zombiell/CQ-prism-lengjing/media/指标8_尺寸规范_长度.jpg

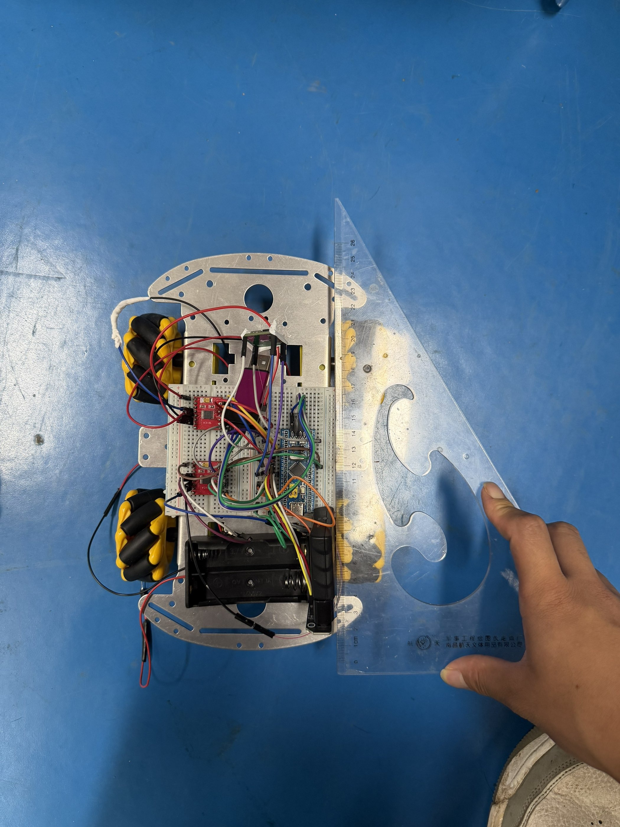
media/指标8_尺寸规范_长度.jpg
