zombiell/CQ-prism-lengjing/README.md

# CRTC2026 参赛机器人 —— 四轮麦克纳姆轮全向移动平台

> 重庆大学机器人训练大赛（CRTC2026）参赛作品
> 队伍：**CQ prism 棱镜战队**　队长：**李汶骏**

## 项目简介

本项目是一台基于 **STM32F103C8T6** 微控制器的四轮**麦克纳姆轮**全向移动机器人，通过 **PS2 无线手柄**遥控，能够实现**前进、后退、左移、右移、斜向移动、原地自转**等全向运动。

机器人的开发重点在于**底层驱动的从零实现**：PS2 手柄的通信协议由软件模拟时序实现，电机 PWM 与正反转切换由定时器直接控制，麦克纳姆轮的逆运动学解算与死区补偿算法均在固件中自行推导与实现。

## 队伍成员与分工

| 姓名 | 角色 | 职责 |
| --- | --- | --- |
| 李汶骏 | 队长 / 电控·硬件 / **操作手** | 统筹规划、对外沟通；嵌入式程序编写、电路设计、控制单元调试；比赛现场操作机器人 |
| 王佳杰 | 机械 | 机械结构设计、组装与维护 |
| 敬杨 | 机械 | 机械结构设计、组装与维护 |
| 付国强 | 机械 | 机械结构设计、组装与维护 |

> 比赛现场由李汶骏担任操作手（规则允许每队不超过 2 人进场，本队安排 1 人操作）。

## 技术规格

| 项目 | 参数 |
| --- | --- |
| 主控芯片 | STM32F103C8T6（ARM Cortex-M3，72MHz，64KB Flash，20KB RAM） |
| 电机驱动 | DRV8833 双 H 桥驱动模块 **× 2**（每模块驱动 2 个电机） |
| 电机 | TT 减速马达 × 4（单轴 1:48） |
| 轮系 | 60mm 麦克纳姆轮 × 4（X 形布局） |
| 遥控方式 | PS2 无线手柄 + 接收器（2.4GHz） |
| PWM 频率 | 20kHz（72MHz ÷ 3600） |
| 遥控信号刷新率 | 100Hz（每 10ms 一次） |
| 供电 | **2S 18650 锂电池组**（额定 **7.4V**，满电 8.4V，实测空载 8.0V），仅 1 个供电模块 |
| 调试接口 | USART1 @ 115200bps |

## 已完成的功能指标

| 编号 | 指标名称 | 实现方式 |
| --- | --- | --- |
| 1 | 外形展示 | ✅ 具备**能量单元**的完整机体（四轮麦轮底盘 + 电源 + 主控 + 能量单元安装位）；绕车一周展示视频已录制 |
| 2 | 电机运动（单一） | ✅ 已实现 `chassis_wheel_test()` 可单独驱动任意一个电机；视频已录制 |
| 3 | 电机运动（全部） | ✅ **8 路 PWM**（4 个电机 × 2 路）同时输出；视频已录制 |
| 6 | 底盘运动（单一） | ✅ PS2 手柄控制单方向平移；视频已录制（手柄与车体同框） |
| 7 | 底盘运动（全部） | ✅ PS2 手柄控制全向运动；视频已录制（手柄与车体同框） |
| 8 | 尺寸规范 | ✅ 实测 **187×169×130 mm**、**1.08 kg**（限值 290×195×210mm、2.0kg） |
| 11 | 结构稳定性 | ✅ 180mm 底面朝下自由落体，**无零件掉出**；视频已录制 |
| 12 | 规划/现有采购单 | ✅ 选型对比与成本核算 ¥178.75，见 [docs/02](./docs/02-需求分析与选型采购.md) |

**已完成的 8 项基础功能指标：1、2、3、6、7、8、11、12，演示视频全部录制完成。**

**未完成的 4 项指标（舵机运动 4、5；方块携带 9、10）**：原因与后续计划见
[docs/11 舵机运动](./docs/11-舵机运动.md) 与 [docs/12 方块携带](./docs/12-方块携带.md)。

## 目录结构

```
.
├── README.md                     本文件
├── docs/                         中期考核技术文档（Markdown）
│   ├── README.md                 文档导航页
│   ├── 01-项目概述与技术路线.md
│   ├── 02-需求分析与选型采购.md
│   ├── 03-电源管理与电气规范.md
│   ├── 04-电机驱动与PWM调速.md
│   ├── 05-麦克纳姆轮运动学解算.md
│   ├── 06-PS2手柄通信与遥控.md
│   ├── 07-底盘结构与外形.md
│   ├── 08-尺寸测量与结构强度.md
│   ├── 09-调试过程与问题排查.md
│   ├── 10-开源项目使用说明.md
│   ├── 11-舵机运动.md            未完成指标说明
│   └── 12-方块携带.md            未完成指标说明
├── firmware/                     固件完整源码
│   ├── Core/                     Inc / Src
│   ├── Drivers/                  STM32F1 HAL 库 + CMSIS
│   ├── cmake/                    交叉编译工具链配置
│   ├── CMakeLists.txt
│   ├── CMakePresets.json
│   ├── startup_stm32f103xb.s     启动文件
│   ├── STM32F103xx_FLASH.ld      链接脚本
│   └── romote_movtion.ioc        CubeMX 工程文件
└── media/                        演示图片
```

## 固件结构

| 文件 | 层次 | 职责 |
| --- | --- | --- |
| `Core/Src/ps2.c` | 驱动层 | 软件模拟 SPI 时序，读取 PS2 手柄 9 字节数据帧并校验 |
| `Core/Src/motor.c` | 驱动层 | 浮点占空比 → 定时器比较值；含软启动斜坡与**马达死区补偿** |
| `Core/Src/chassis.c` | 算法层 | 麦轮逆运动学解算、归一化、四轮降额 |
| `Core/Src/main.c` | 应用层 | 时间片调度、按键解析、急停安全逻辑、调试打印 |

## 快速开始

1. 用 STM32CubeIDE 或 CMake + arm-none-eabi-gcc 打开 **`firmware/`** 目录（源码根目录含 `CMakeLists.txt`）
2. 编译生成 `.hex` / `.bin`
3. 用 ST-Link 烧录到 STM32F103C8T6
4. 按下表连接 PS2 接收器：

   | 接收器引脚 | STM32 引脚 |
   | --- | --- |
   | GND | GND |
   | VCC | 3.3V 或 5V |
   | DATA | PA4 |
   | CMD | PA5 |
   | CS | PA6 |
   | CLK | PA7 |

5. 上电后**先按一次 START 键**解除急停锁存，即可用手柄遥控

## 操作映射

| 手柄按键 | 机器人动作 |
| --- | --- |
| ↑ / ↓ | 前进 / 后退 |
| ← / → | 左移 / 右移 |
| ↑ + ← / ↑ + → 等 | 斜向 45° 移动（四组） |
| ○ / □ | 原地顺时针 / 逆时针自转 |
| 方向键 + ○/□ | 边走边转 |
| **START** | 解除急停锁存 |
| **SELECT** | 紧急停车（锁存，需 START 解除） |

> 本手柄摇杆无模拟量输出（官方手册明确说明），因此**必须使用十字方向键**控制，推摇杆不会产生平移。

## 文档

全部技术文档在 **[`docs/`](./docs/)** 目录，共 **10 篇**，入口见 [docs/README.md](./docs/README.md)（文档导航页）。

| 文档 | 对应指标 |
| --- | --- |
| [01 项目概述与技术路线](./docs/01-项目概述与技术路线.md) | — |
| [02 需求分析与选型采购](./docs/02-需求分析与选型采购.md) | 12 |
| [03 电源管理与电气规范](./docs/03-电源管理与电气规范.md) | — |
| [04 电机驱动与PWM调速](./docs/04-电机驱动与PWM调速.md) | 2、3 |
| [05 麦克纳姆轮运动学解算](./docs/05-麦克纳姆轮运动学解算.md) | — |
| [06 PS2手柄通信与遥控](./docs/06-PS2手柄通信与遥控.md) | 6、7 |
| [07 底盘结构与外形](./docs/07-底盘结构与外形.md) | 1 |
| [08 尺寸测量与结构强度](./docs/08-尺寸测量与结构强度.md) | 8、11 |
| [09 调试过程与问题排查](./docs/09-调试过程与问题排查.md) | — |
| [10 开源项目使用说明](./docs/10-开源项目使用说明.md) | — |

## 开源说明

本项目在开发过程中使用了 STM32 HAL 库、CMSIS 等开源组件，并参考了塔克创新（XTARK）的 PS2 手柄驱动结构（代码已重写）。
完整的开源组件清单、许可证、以及我们对参考实现的修改说明，见 **[10 开源项目使用说明](./docs/10-开源项目使用说明.md)**。
