zombiell/CQ-prism-lengjing/docs/10-开源项目使用说明.md

# 10 开源项目使用说明

> 依据竞赛手册第 3 章要求：
> 「**参赛队伍应自行制作参赛机器人**……将**开源项目用于机器人的制作及代码编写是允许的，但必须在中期考核阶段给出完整说明**，并遵守所使用开源项目的开源协议。」

本篇完整说明本项目使用的所有开源组件、许可证、以及我们对开源代码的修改与二次开发内容。

---

## 开源组件清单

| # | 组件 | 版本 | 来源 | 许可证 | 在本项目中的用途 |
| --- | --- | --- | --- | --- | --- |
| 1 | **STM32F1xx HAL Driver** | CubeMX 生成 | STMicroelectronics | **BSD-3-Clause** | 外设驱动（GPIO/TIM/UART/RCC） |
| 2 | **CMSIS Core** | 随 CubeMX | ARM Limited | **Apache-2.0** | Cortex-M3 内核访问层 |
| 3 | **CMSIS Device（STM32F1xx）** | 随 CubeMX | STMicroelectronics | ST 授权 | STM32F103 寄存器定义、启动文件 |
| 4 | **STM32CubeMX 生成代码模板** | — | STMicroelectronics | ST 授权 | 时钟/GPIO/定时器/串口初始化框架 |
| 5 | **塔克创新 PS2 手柄驱动（参考）** | V1.0 | 塔克创新（XTARK） | 厂商提供参考代码 | **仅参考结构，已重写** |
| 6 | **newlib / newlib-nano** | 随工具链 | GNU Arm 工具链 | LGPL / BSD 混合 | `printf` 等 C 标准库函数 |
| 7 | **arm-none-eabi-gcc** | 14.3.1 | GNU Arm Embedded Toolchain | GPL（工具链本身） | 交叉编译 |
| 8 | **CMake** | 3.22+ | Kitware | BSD-3-Clause | 构建系统 |

---

## 各组件详细说明

### 1. STM32F1xx HAL Driver（BSD-3-Clause）

**来源**：STMicroelectronics 官方提供，随 STM32CubeMX 生成。

**许可证原文**（`Drivers/STM32F1xx_HAL_Driver/LICENSE.txt`）：

> This software component is provided to you as part of a software package and applicable license terms are in the Package_license file. If you received this software component outside of a package or without applicable license terms, the terms of the **BSD-3-Clause** license shall apply.

**本项目使用方式**：

- **直接使用，未修改**：`stm32f1xx_hal.c`、`stm32f1xx_hal_tim.c`、`stm32f1xx_hal_gpio.c`、`stm32f1xx_hal_uart.c` 等
- 通过 HAL API 完成外设配置与操作，例如：
  - `HAL_TIM_PWM_Start()` 启动 PWM 输出
  - `HAL_GPIO_ReadPin()` / `HAL_GPIO_WritePin()` 操作 GPIO
  - `HAL_UART_Init()` 配置串口
- **未修改 HAL 库源码的任何内容**

**遵守 BSD-3-Clause 的方式**：保留原始版权声明与 LICENSE 文件（`firmware/Drivers/STM32F1xx_HAL_Driver/LICENSE.txt`）。

### 2. CMSIS Core（Apache-2.0）

**来源**：ARM Limited 的 Cortex Microcontroller Software Interface Standard。

**许可证**：`Drivers/CMSIS/LICENSE.txt` 明确为 **Apache License Version 2.0**。

**本项目使用方式**：

- 通过 CMSIS 提供的宏访问内核寄存器，例如：
  - `__disable_irq()` 在 `Error_Handler()` 中关闭中断
  - `__HAL_RCC_*_CLK_ENABLE()` 使能外设时钟（实际是 CMSIS + HAL 的宏封装）
- 提供 `core_cm3.h` 中的 NVIC、SysTick 等内核外设访问
- **未修改 CMSIS 源码**

**遵守 Apache-2.0 的方式**：保留 LICENSE 文件与版权声明；未修改，无需额外声明修改记录。

### 3. CMSIS Device — STM32F1xx

**来源**：STMicroelectronics，包含 `stm32f103xb.h`（寄存器定义，842KB）、`system_stm32f1xx.c`（系统时钟初始化）、启动文件 `startup_stm32f103xb.s`。

**本项目使用方式**：

- 直接引用寄存器定义，例如 `USART1->SR`、`TIM2->CCR1`、`AFIO->MAPR` 等
- `SystemInit()` 在启动时调用
- **未修改**

### 4. STM32CubeMX 生成代码

**来源**：STMicroelectronics 的代码生成器。

**本项目中的文件**（由 CubeMX 生成，我们仅在 `USER CODE` 区块内添加自己的代码）：

| 文件 | 我们的修改 |
| --- | --- |
| `Core/Src/main.c` | 在 `USER CODE BEGIN/END` 区块内添加应用逻辑 |
| `Core/Src/tim.c` | **未修改**（仅使用生成的初始化） |
| `Core/Src/gpio.c` | **未修改** |
| `Core/Src/usart.c` | **未修改** |
| `Core/Src/stm32f1xx_it.c` | **未修改**（SysTick 中断调用 `HAL_IncTick()`） |
| `Core/Src/stm32f1xx_hal_msp.c` | **未修改** |
| `Core/Src/syscalls.c` / `sysmem.c` | **未修改** |

> **CubeMX 的 `USER CODE` 机制**：生成器只会保留 `/* USER CODE BEGIN xxx */` 与 `/* USER CODE END xxx */` 之间的内容，其余部分每次重新生成都会被覆盖。我们**严格遵守这个约定**，所有自写代码都放在 `USER CODE` 区块内，因此 `.ioc` 文件可随时重新生成而不丢失代码。

### 5. 塔克创新 PS2 手柄驱动（参考实现）

**来源**：塔克创新（XTARK）提供的 PS2 无线手柄参考程序，随手柄配套资料赠送。

**原始文件**：

- `Driver/ax_ps2.c`、`Driver/ax_ps2.h`（STM32F1 版）
- `User/main.c`（4WD 小车例程）

**⚠️ 本项目的做法：参考协议与时序逻辑，代码已完全重写。**

我们对照厂商代码理解了以下关键点（这些是硬件协议的客观事实，不属于代码著作权范围）：

| 项目 | 内容 |
| --- | --- |
| 引脚分配 | PA4=DAT、PA5=CMD、PA6=CS、PA7=CLK |
| 命令数组 | `{0x01, 0x42, 0x00, ..., 0x00}` 共 9 字节 |
| 位顺序 | LSB 先行 |
| 半周期延时 | 16µs |
| 采样时刻 | 时钟低电平期间读取 DAT |
| 取反约定 | `btn = ~data` 使"1 = 按下" |

**我们重写并新增的部分**：

| 项目 | 厂商原版 | 本项目 |
| --- | --- | --- |
| 文件组织 | `ax_ps2.c` + 独立 `ax_delay.c` | 合并进 `ps2.c`，延时内置 |
| 微秒延时 | `AX_Delayus()`（未知实现） | **TIM1 自由计数器**（1MHz，明确可靠） |
| 引脚定义 | `PAout(5)=1` 宏 | `HAL_GPIO_WritePin()` 标准 HAL 调用 |
| **数据校验** | **无** | **✅ 新增两层校验**（模式字节 + 0x5A 固定字节） |
| **掉线检测** | **无**（void 函数） | **✅ 返回 1/0**，调用方可判断数据有效性 |
| 取反类型转换 | `btn1 = ~PS2_data[3]`（隐式截断） | `(uint8_t)(~ps2_rx[3])`（显式，语义清晰） |
| 结构体 | `JOYSTICK_TypeDef` | `ps2_state_t`（重新命名并加注释） |

**为什么这样处理**：厂商代码是**硬件协议的参考实现**，而硬件协议（字节定义、时序要求）是客观事实，任何驱动都必须遵循。但具体代码组织、错误处理、接口设计由我们独立完成。

**遵守的方式**：在本文件（`docs/10`）中**完整说明参考来源与我们的改动**，满足竞赛手册"必须给出完整说明"的要求。

### 6. newlib / newlib-nano

**来源**：GNU Arm Embedded Toolchain 自带的 C 标准库。

**本项目使用方式**：

- `printf()` 用于串口调试输出
- **重定向 `_write()` 到 USART1**（覆盖 newlib 的弱符号）：

```c
int _write(int file, char *ptr, int len)
{
    (void)file;
    for (int i = 0; i < len; i++) {
        while (!(USART1->SR & USART_SR_TXE)) { }
        USART1->DR = (uint8_t)ptr[i];
    }
    while (!(USART1->SR & USART_SR_TC)) { }
    return len;
}
```

- **链接选项 `-u _printf_float`**：newlib-nano 默认不支持浮点格式化，加这个选项让 `%f` 可用

### 7. arm-none-eabi-gcc

**用途**：交叉编译生成 STM32 可执行文件。**仅作为工具使用**，其 GPL 许可证不传染到我们的代码（因为我们是链接其运行时库，而非修改编译器本身）。

### 8. CMake

**用途**：构建系统。项目由 STM32CubeMX 的 CMake 转换工具生成，我们仅添加了用户源文件与链接选项。

---

## 我们自己的原创代码

以下模块**完全由本队独立编写**，未参考任何外部实现：

| 文件 | 行数 | 内容 |
| --- | --- | --- |
| `Core/Src/motor.c` | 约 250 行 | 死区补偿算法、软启动斜坡、PWM 写入、H 桥控制 |
| `Core/Src/chassis.c` | 约 180 行 | **麦克纳姆轮逆运动学**、归一化、四轮降额、方向标定 |
| `Core/Src/ps2.c` | 约 200 行 | PS2 协议实现（参考厂商结构后重写）、两层数据校验、TIM1 微秒延时 |
| `Core/Src/main.c` 的应用逻辑 | 约 200 行 | 时间片调度、按键解析、急停状态机、死区补偿的调试验证 |
| `Core/Inc/motor.h` / `chassis.h` / `ps2.h` | — | 接口定义与参数说明 |

**核心技术亮点**（均独立推导实现）：

1. **马达静摩擦死区补偿算法**（`motor_deadzone_comp`）—— 从故障现象出发，通过实测定位根因，设计线性映射方案
2. **麦轮逆运动学 + 归一化**（`chassis_mecanum`）—— 标准公式的正确实现，含归一化保障方向不变形
3. **两层协议数据校验**（`PS2_Scan`）—— 比厂商参考实现更健壮
4. **软启动斜坡 + 影子变量同步机制**（`motor_set_ramp`）—— 含"绕过斜坡时必须清影子变量"的完整处理

详见 [04 电机驱动与PWM调速](./04-电机驱动与PWM调速.md)、[06 PS2手柄通信与遥控](./06-PS2手柄通信与遥控.md)、[05 麦克纳姆轮运动学解算](./05-麦克纳姆轮运动学解算.md)。

---

## 开源协议遵守情况汇总

| 组件 | 许可证 | 保留版权声明 | 保留 LICENSE 文件 | 修改声明 | 遵守 |
| --- | --- | --- | --- | --- | --- |
| STM32F1xx HAL Driver | BSD-3-Clause | ✅ 源文件头部保留 | ✅ `firmware/Drivers/STM32F1xx_HAL_Driver/LICENSE.txt` | 未修改 | ✅ |
| CMSIS Core | Apache-2.0 | ✅ 保留 | ✅ `firmware/Drivers/CMSIS/LICENSE.txt` | 未修改 | ✅ |
| CMSIS Device STM32F1xx | ST 授权 | ✅ 保留 | ✅ `firmware/Drivers/CMSIS/Device/ST/STM32F1xx/LICENSE.txt` | 未修改 | ✅ |
| STM32CubeMX 生成代码 | ST 授权 | ✅ 保留头部注释 | — | 修改均在 `USER CODE` 区块内 | ✅ |
| 塔克创新 PS2 参考 | 厂商参考代码 | ✅ 本文件说明 | — | **已重写，改动见上表** | ✅ |
| newlib | LGPL/BSD 混合 | ✅ 工具链自带 | — | 仅覆盖 `_write` 弱符号 | ✅ |
| arm-none-eabi-gcc | GPL（工具） | — | — | 仅作为工具使用 | ✅ |
| CMake | BSD-3-Clause | ✅ | — | 仅作构建系统 | ✅ |

**所有 LICENSE 文件均完整保留在 `firmware/` 目录中**，未删除任何版权声明。

---

## 第三方资源（非代码）

| 资源 | 来源 | 用途 | 许可 |
| --- | --- | --- | --- |
| 《塔克创新 PS2 无线手柄使用指导手册 V1.0.3》 | 塔克创新 | 协议参考 | 随手柄提供，仅内部参考 |
| 《CRTC2026 参赛手册 V1.5》 | CRTC2026 组委会 | 规则依据 | 组委会发布 |
| STM32F103x8/xB 数据手册 | STMicroelectronics | 芯片参数 | 公开文档 |
| RM0008 参考手册 | STMicroelectronics | 寄存器说明 | 公开文档 |

> 上述文档**未包含在提交仓库中**（仅作为开发参考），避免版权问题。

---

## 声明

本队声明：

1. 本项目使用的所有开源组件均已在上表列明，**无遗漏、无隐瞒**；
2. 所有保留的版权声明与 LICENSE 文件**完整未删改**；
3. 对参考实现的修改与二次开发内容**已在上文完整说明**；
4. 机器人的**硬件设计、运动学算法、控制逻辑、错误处理机制**均为本队独立完成；
5. 本项目**未使用任何成品商品机器人或机器人套件**（符合竞赛手册第 3 章"严禁直接购买功能成熟的商品机器人或机器人套件等参与比赛"的要求）。

如对开源使用情况有疑问，请联系本队队长。

---

**CQ prism 棱镜战队**
队长 / 操作手：李汶骏
