zombiell/CQ-prism-lengjing/docs/11-舵机运动.md

# 11 舵机运动

> 对应中期考核指标 **4：舵机运动（单一）**、**5：舵机运动（多项）**

## ⬜ 本阶段未实现

本阶段（中期考核前）集中完成**全向移动底盘**的设计与调试，舵机相关功能尚未开始实现，故本文档暂留空。

---

## 指标要求（依据竞赛手册）

| 编号 | 指标 | 要求 |
| --- | --- | --- |
| 4 | 舵机运动（单一） | 能完成至少一个舵机的转动 |
| 5 | 舵机运动（多项） | 同一台机器人能完成至少三个舵机的转动，并确保其可动机构能够在任意非初始状态下保持相对静止 |

---

## 未完成原因

| 原因 | 说明 |
| --- | --- |
| 优先级安排 | 中期考核前将资源集中投入移动底盘，这是后续所有功能（抓取、收集）的基础 |
| 结构未定型 | 舵机的安装位置依赖抓取机构的结构设计，机构方案尚未定型 |
| 需要可自锁机构 | 指标 5 要求机构在任意非初始状态下保持静止，需要具备自锁能力的传动设计 |

---

## 后续实现计划

通过中期考核后，按下述顺序推进：

| 阶段 | 内容 |
| --- | --- |
| 1 | 完成抓取机构的三维结构设计（Fusion360），确定舵机安装位 |
| 2 | 选用官方物资表中的 MG995（2 个）与 SG90（4 个）舵机 |
| 3 | 固件层新增 `servo.c`：用定时器输出 50Hz PWM，脉宽 0.5~2.5ms 对应 0~180° |
| 4 | 实现单舵机控制（指标 4） |
| 5 | 实现三舵机协同 + 机构自锁（指标 5） |

### 预研技术点

| 技术点 | 方案 |
| --- | --- |
| 舵机 PWM 频率 | 50Hz（周期 20ms），与本项目电机 PWM 的 20kHz 不同，需单独的定时器通道 |
| 脉宽与角度 | 0.5ms → 0°，1.5ms → 90°，2.5ms → 180° |
| 多舵机同步 | 同一定时器的不同通道，共用 50Hz 时基 |
| 机构自锁 | 采用蜗轮蜗杆或大减速比齿轮组，使舵机断电后仍能保持位置 |

---

## 验收标准（待实现后补充）

| 指标 | 验收方式 | 状态 |
| --- | --- | --- |
| 4 舵机运动（单一） | 视频演示单个舵机从 0° 转到 180° 再回位 | ⬜ 待实现 |
| 5 舵机运动（多项） | 视频演示 3 个舵机协同动作，断电后机构保持静止 | ⬜ 待实现 |

---

## 文档状态

| 项目 | 状态 |
| --- | --- |
| 结构设计 | ⬜ 未开始 |
| 硬件选型 | ⬜ 未开始（计划使用官方物资表内舵机） |
| 固件实现 | ⬜ 未开始 |
| 功能验证 | ⬜ 未开始 |
| 演示视频 | ⬜ 未录制 |

**本文档将在上述功能实现后完整补充。**
