zombiell/CQ-prism-lengjing/docs/12-方块携带.md

# 12 方块携带

> 对应中期考核指标 **9：方块携带（单一）**、**10：方块携带（多项）**

## ⬜ 本阶段未实现

本阶段（中期考核前）集中完成**全向移动底盘**的设计与调试，抓取与携带功能尚未开始实现，故本文档暂留空。

---

## 指标要求（依据竞赛手册）

| 编号 | 指标 | 要求 |
| --- | --- | --- |
| 9 | 方块携带（单一） | 至少一台机器人可自主使至少一颗在地面静止的方块（**30×30×30mm**）由非携带状态转变为携带状态 |
| 10 | 方块携带（多项） | 在保持携带状态下，使至少另一块在地面静止的方块由非携带状态转变为携带状态（即同时携带 ≥2 块） |

### 方块规格（依据手册）

| 项目 | 规格 |
| --- | --- |
| 外形尺寸 | **30 × 30 × 30 mm** |
| 内部镂空 | 15 × 15 × 15 mm |
| 棱边处理 | 12 条棱边均有 45° 倒角（斜面 2.121mm） |
| 质量 | 约 **11.29 g** |
| 颜色 | 白色为**能量单元**（1 分/个，场地共 18 个）<br>黄色为**能量核心**（4 分/个，场地共 5 个） |

---

## 未完成原因

| 原因 | 说明 |
| --- | --- |
| 依赖抓取机构 | 携带方块必须由抓取机构完成，而抓取机构尚未设计与安装 |
| 优先级安排 | 中期考核前资源集中于移动底盘，保证基础功能稳定可靠 |
| 指标 10 难度更高 | 需同时携带 ≥2 块，对机构容量与结构强度要求更高 |

---

## 后续实现计划

| 阶段 | 内容 |
| --- | --- |
| 1 | 设计抓取机构：考虑**夹爪式**与**铲取式**两种方案，需满足 30mm 方块的抓取与保持 |
| 2 | 实现单块抓取（指标 9）：机构张开 → 对准方块 → 闭合夹紧 → 抬起 |
| 3 | 验证携带稳定性：行驶、转向、过坡道时方块不脱落 |
| 4 | 扩展为多块携带（指标 10）：设计可容纳 2~3 块的料仓或并列夹爪 |

### 预研技术点

| 技术点 | 方案 |
| --- | --- |
| 抓取方式 | 夹爪式（舵机驱动）／铲取式（被动结构，靠车体推入） |
| 方块检测 | 可用微动开关或红外对管判断是否已抓取成功 |
| 保持能力 | 夹爪需有足够夹持力，或采用自锁机构防止行驶中松脱 |
| 料仓设计 | 若用铲取式，可设计斜面导槽让方块依次滑入并叠放 |

---

## 验收标准（待实现后补充）

| 指标 | 验收方式 | 状态 |
| --- | --- | --- |
| 9 方块携带（单一） | 视频演示：机器人自主接近地面静止方块 → 抓取 → 携带移动 | ⬜ 待实现 |
| 10 方块携带（多项） | 视频演示：携带第 1 块的状态下，再抓取第 2 块并同时保持 | ⬜ 待实现 |

---

## 文档状态

| 项目 | 状态 |
| --- | --- |
| 机构方案设计 | ⬜ 未开始 |
| 硬件加工 | ⬜ 未开始 |
| 固件实现 | ⬜ 未开始 |
| 功能验证 | ⬜ 未开始 |
| 演示视频 | ⬜ 未录制 |

**本文档将在上述功能实现后完整补充。**
