zombiell/CQ-prism-lengjing/docs/02-需求分析与选型采购.md

# 02 需求分析与选型采购

> 对应中期考核指标 **12：规划/现有采购单**（队伍核心部件的选型、整机成本预算）

## 功能需求分解

在设计机器人之前，我们先把竞赛任务拆解成可执行的技术需求。

### 从竞赛任务推导出的需求

| 竞赛要求 | 推导出的技术需求 | 优先级 |
| --- | --- | --- |
| 在 2400×2400mm 场地内快速到达任意位置 | **全向移动能力**（能横向平移，不必先转向） | ★★★ 最高 |
| 场地有高台（300mm）、台阶（150mm）、坡道、桥梁 | 底盘通过性；暂时不追求越障，先保证平整地面可靠 | ★★ |
| 需要把道具带回起点 | **抓取携带机构**（中期考核后实现） | ★★★ |
| 比赛是双方对抗，需要快速反应 | 遥控延迟要低（<100ms），操作要跟手 | ★★★ |
| 每台仅 1 个供电模块，≤7.4V | 电源系统必须简单可靠 | ★★★ |
| 成本 ≤¥400 | 选型必须控制成本，不能用高价方案 | ★★★ |

### 关键架构决策：为什么选全向底盘

这是本项目最重要的一个决策，我们对比了三种方案：

| 方案 | 横向移动 | 成本 | 机械复杂度 | 结论 |
| --- | --- | --- | --- | --- |
| **普通轮（差速驱动）** | ❌ 不能，必须先转向再前进 | 最低 | 低 | 无法满足"快速占位"需求 |
| **全向轮（Omni）** | ✅ 能，但四个轮子要独立悬挂才稳 | 中 | 中 | 对装配精度要求高 |
| **麦克纳姆轮（Mecanum）** | ✅ 能，且四轮固定安装即可 | 中 | 低 | **✅ 采用** |

**选择麦克纳姆轮的理由**：它在"能横着走"的同时，**机械结构最简单**——四个轮子直接固定在矩形底盘的四个角上，不需要转向机构，也不需要独立悬挂。对新手队伍来说，这是**性价比最高的全向方案**。

## 主控选型对比

| 型号 | 主频 | Flash | RAM | 价格 | 生态 | 结论 |
| --- | --- | --- | --- | --- | --- | --- |
| Arduino UNO (ATmega328P) | 16MHz | 32KB | 2KB | ¥20 | 极好 | ❌ 只有 6 路 PWM，不够 8 路；无浮点运算能力 |
| STM32F103C8T6 | 72MHz | 64KB | 20KB | **¥9.4** | 好 | **✅ 采用** |
| STM32F407VET6 | 168MHz | 512KB | 192KB | ¥40+ | 好 | ⚠️ 性能溢出，成本超标 |
| ESP32 | 240MHz | 4MB | 520KB | ¥15 | 好 | ⚠️ 无线功能用不上（规则要求 PS2 手柄） |

**为什么选 STM32F103C8T6**：

1. **PWM 通道数够**：TIM2 四个通道 + TIM3 四个通道 = **正好 8 路**，对应 4 个电机的 8 根驱动线
2. **72MHz 主频足够**：麦轮解算涉及浮点运算，72MHz 能轻松在 10ms 周期内完成
3. **成本最低**（¥9.4），符合 ≤¥400 的总预算约束
4. **Cortex-M3 内核 + HAL 库**，资料丰富，出问题好查
5. 规则不限制主控型号，用官方物资表里的型号最稳妥

## 电机与驱动选型对比

### 电机方案

| 方案 | 扭矩 | 转速 | 价格 | 结论 |
| --- | --- | --- | --- | --- |
| 普通 130 直流电机 | 低 | 高 | ¥2 | ❌ 扭矩太小，带不动 2kg 车体 |
| **TT 减速马达（单轴 1:48）** | 中 | 中 | **¥2.83** | **✅ 采用** |
| 520 减速电机 | 高 | 中 | ¥15+ | ⚠️ 扭矩过剩，成本超 |
| 步进电机 | 高 | 低 | ¥20+ | ❌ 需要专用驱动器，成本和复杂度都上升 |

**为什么选 TT 马达**：单轴 1:48 减速比，在"有足够扭矩推动车体"和"转速不至于太慢"之间平衡得最好，且价格极低（¥2.83/个）。四驱方案下单个电机只需承担 1/4 的推力需求。

> ⚠️ **后续踩到的坑**：TT 马达配塑料减速箱，**静摩擦很大**，导致低占空比时转子锁死不转。这个特性在设计阶段被低估了，详见 [09-调试过程与问题排查](./09-调试过程与问题排查.md)。

### 驱动方案

| 方案 | 单路持续电流 | 压降 | 价格 | 结论 |
| --- | --- | --- | --- | --- |
| L298N | 2A | **约 1.4~2V（视电流，偏高）** | ¥8 | ❌ 压降太大，电机拿到的电压损失严重 |
| **DRV8833** | 1.5A | **约 0.3~0.6V（视电流，低）** | **¥2.27** | **✅ 采用（2 个模块）** |
| TB6612FNG | 1.2A | 约 0.5V | ¥6 | ⚠️ 性能相当但价格更高 |
| BTS7960 | 43A | 低 | ¥25 | ❌ 大材小用，成本超标 |

**为什么选 DRV8833**：

1. **压降只有约 0.3~0.6V**（L298N 约 1.4~2V）—— 对 7.4V 的低压系统，压降直接决定电机能拿到多少电压，这一条最关键
2. **每个模块是双路 H 桥，能驱动 2 个电机** → 4 个电机只需 **2 个模块**
3. 价格便宜（¥2.27/个），2 个合计仅 ¥4.54
4. 内部集成过流保护、欠压保护、过热保护

> 注：《CRTC官方物资表》中 DRV8833 模块列为 4 个（按两套车或含备用配置）；本队单台机器人实际使用 **2 个**。

**DRV8833 控制真值表**（这是 `motor.c` 实现的依据）：

| IN1 | IN2 | 电机状态 |
| --- | --- | --- |
| PWM | 0 | 正转，转速由占空比决定 |
| 0 | PWM | 反转 |
| 0 | 0 | **滑行停止**（coast，输出断开，靠惯性转） |
| 1 | 1 | **刹车**（brake，电机两端短接，停得干脆） |

每个电机占用两路 PWM（IN1/IN2），8 路 PWM 正好对应 4 个电机：

| 电机 | IN1（正转线） | IN2（反转线） | 所属驱动模块 |
| --- | --- | --- | --- |
| 前左 FL | PA0 / TIM2_CH1 | PA1 / TIM2_CH2 | DRV8833 #1 |
| 前右 FR | PA2 / TIM2_CH3 | PA3 / TIM2_CH4 | DRV8833 #1 |
| 后左 RL | PB4 / TIM3_CH1 | PB5 / TIM3_CH2 | DRV8833 #2 |
| 后右 RR | PB0 / TIM3_CH3 | PB1 / TIM3_CH4 | DRV8833 #2 |

## 轮系选型

| 方案 | 直径 | 载重 | 价格 | 结论 |
| --- | --- | --- | --- | --- |
| 普通橡胶轮 | 65mm | 好 | ¥3 | ❌ 不能全向 |
| **60mm 麦克纳姆轮** | 60mm | 中 | **¥35/套（4 个）** | **✅ 采用** |
| 80mm 麦轮 | 80mm | 好 | ¥50+ | ⚠️ 车体变高，可能超尺寸限制 |

**为什么选 60mm 麦轮**：尺寸小、车体重心低，有利于满足"高度 ≤210mm"的限制；一套 4 个 ¥35，成本可控。

## 遥控方案选型

| 方案 | 延迟 | 成本 | 开发难度 | 规则符合性 | 结论 |
| --- | --- | --- | --- | --- | --- |
| **PS2 无线手柄** | 低 | **¥45/套** | 中（需自己实现协议） | ✅ 官方指定 | **✅ 采用** |
| 蓝牙手机 App | 中 | ¥10 | 低 | ⚠️ 规则允许，但手机操作手感差 | ❌ |
| 自建 2.4G（nRF24L01） | 低 | ¥15 | 高（要写两端） | ✅ 允许 | ⚠️ 两个收发端都要做，工作量大 |
| WiFi（ESP8266） | **高（100ms+）** | ¥12 | 中 | ✅ 允许 | ❌ 延迟不满足对抗需求 |

**为什么选 PS2 手柄**：规则明确推荐，且**按键手感、延迟、抗干扰都经过游戏机市场验证**。代价是需要自己实现通信协议——但这正好是我们可以体现技术深度的地方。

## 整机成本预算表

### 官方物资表价格（依据《CRTC官方物资表》）

| 序号 | 物品名称 | 款式 | 数量 | 单价 | 总价 |
| --- | --- | --- | --- | --- | --- |
| 1 | STM32F103C8T6 核心板 | STM32F103C8T6_Micro_焊接 | 2 | ¥9.40 | ¥18.80 |
| 2 | MG995 舵机 | MG995舵机_180度_铁+铜齿轮 | 2 | ¥14.50 | ¥29.00 |
| 3 | SG90 舵机 | SG90舵机_180度 | 4 | ¥5.90 | ¥23.60 |
| 4 | PS2 手柄 | PS2无线手柄锁定款+直插转接板(排针) | 2 | ¥45.00 | ¥90.00 |
| 5 | TT 马达 | 单轴1比48 | 8 | ¥2.83 | ¥22.64 |
| 6 | 麦克纳姆轮 | 60mm 黄色麦轮一套4个 TT马达联轴器 | 2 | ¥35.00 | ¥70.00 |
| 7 | 小车底盘 | 4轮金属底盘折弯板(一体带马达孔) | 2 | ¥11.20 | ¥22.40 |
| 8 | STLink | ST-LINK V2 仿真器 进口芯片软件可升级版本 | 1 | ¥12.42 | ¥12.42 |
| 9 | DRV8833 电机驱动模块 | DRV8833驱动模块_红板 | 4 | ¥2.27 | ¥9.08 |
| 10 | DC-DC 降压模块 | Mini降压模块_5V_黑板 | 2 | ¥2.09 | ¥4.18 |
| 11 | 18650 电池 | （自选型号购买） | — | — | — |
| 12 | 18650 电池盒 | 18650_两节_带线 | 2 | ¥1.98 | ¥3.96 |
| 13 | 18650 充电器 | 18650双槽充电器 | 1 | ¥8.60 | ¥8.60 |
| 14 | 面包板 | — | 2 | ¥2.00 | ¥4.00 |
| 15 | 杜邦线 | 10CM/公对公/40P | 1 | ¥2.70 | ¥2.70 |
| 16 | 杜邦线 | 10CM/母对公/40P | 1 | ¥2.40 | ¥2.40 |
| 17 | 杜邦线 | 10CM/母对母/40P | 1 | ¥2.10 | ¥2.10 |
| 18 | 无线继电器 | (DC5-24V) 1个接收器+1个单键 | 2 | ¥13.80 | ¥27.60 |
| | **官方物资表合计** | | | | **¥353.48** |

### 本队单台机器人实际采购预算

#### A. 机器人本体（计入制造成本）

| 类别 | 物品 | 数量 | 单价 | 小计 |
| --- | --- | --- | --- | --- |
| 主控 | STM32F103C8T6 核心板 | 1 | ¥9.40 | ¥9.40 |
| 驱动 | DRV8833 电机驱动模块（双路） | 2 | ¥2.27 | ¥4.54 |
| 动力 | TT 马达（单轴 1:48） | 4 | ¥2.83 | ¥11.32 |
| 轮系 | 60mm 麦克纳姆轮（一套 4 个） | 1 | ¥35.00 | ¥35.00 |
| 底盘 | 4 轮金属底盘折弯板 | 1 | ¥11.20 | ¥11.20 |
| 遥控 | PS2 无线手柄 + 直插转接板 | 1 | ¥45.00 | ¥45.00 |
| 电源 | 18650 电池盒（两节带线，= 1 个供电模块） | 1 | ¥1.98 | ¥1.98 |
| 电源 | DC-DC 降压模块 5V | 1 | ¥2.09 | ¥2.09 |
| 电源 | 18650 电池（自选，约 ¥15/节） | 2 | ¥15.00 | ¥30.00 |
| 辅材 | 杜邦线（公对公/母对公/母对母 各 1 排） | 3 | 约 ¥2.40 | ¥7.20 |
| | **本体小计** | | | **¥157.73** |

#### B. 配套设备（工具/充电器，非机器人本体）

| 类别 | 物品 | 数量 | 单价 | 小计 |
| --- | --- | --- | --- | --- |
| 工具 | STLink V2 仿真器 | 1 | ¥12.42 | ¥12.42 |
| 电源 | 18650 双槽充电器 | 1 | ¥8.60 | ¥8.60 |
| | **配套小计** | | | **¥21.02** |

#### 合计

| 项目 | 金额 |
| --- | --- |
| 机器人本体 | ¥157.73 |
| 配套设备 | ¥21.02 |
| **总计** | **¥178.75** |

**结论**：

- 机器人本体 **¥157.73**，配套设备 ¥21.02，**总计 ¥178.75**
- 即使把全部支出计入，也**远低于 ¥400 的上限**（余量约 ¥221）✅
- 后续增加抓取机构（舵机 MG995 ¥14.5×2 + SG90 ¥5.9×4 + 3D 打印件），仍有余量
- **无线继电器（¥27.60）在通过中期考核后才需要采购**，本阶段不列入

### 成本控制思路

| 措施 | 节省 |
| --- | --- |
| 只买 1 把 PS2 手柄（而非 2 套） | 省 ¥45 |
| 主控板备用 1 块，不买 2 块 | 省 ¥9.4 |
| 杜邦线各买 1 排而非多排 | 省 ¥5 |
| 3D 打印结构件而非购买成品 | 大幅节省 |
| 借用 2025 年回收车辆的零部件（规程允许） | 视情况 |

## 电源方案

### 电池选型

| 项目 | 数值 | 说明 |
| --- | --- | --- |
| 电池类型 | **18650 锂离子电池** | 竞赛规则指定使用 18650 |
| 配置方式 | **2 节串联（2S）** | 装于两节带线电池盒中 |
| **额定电压** | **7.4V**（2 × 3.7V） | ★ 规则要求"额定电压不超过 7.4V"→ **合规** |
| 满电电压 | 8.4V（2 × 4.2V） | 锂电满电时的开路电压 |
| 实测空载电压 | **8.0V** | 电量约 70~80% 时的实测值 |
| 供电模块数量 | **1 个**（1 个两节电池盒） | 规则要求"仅允许 1 个供电模块"→ **合规** |

### 关于"额定电压"与"实测电压"的说明

规则原文：「每台机器人仅允许安装 1 个供电模块，且**供电模块额定电压不超过 7.4V**」。

- **额定电压（nominal voltage）** 是电池的标称工作电压 → **2S = 7.4V，符合要求**
- **满电电压 8.4V / 实测 8.0V** 是锂离子电池在满电状态下的开路电压，属于瞬态值，**不等同于额定电压**
- 类比：手机电池标称 3.7V，满电也是 4.2V —— 这是锂电的正常特性

### 供电拓扑

```
2S 18650 电池组 (7.4V 额定)
        │
        ├──► DRV8833 ×2 的 VM （电机电源，直供 7.4V）
        │
        └──► DC-DC 降压模块 ──► 5V ──► STM32 核心板 / PS2 接收器
```

**为什么电机直供、MCU 降压**：
- TT 马达需要较高电压才有扭矩，所以 DRV8833 的 VM 直接接电池
- STM32 和 PS2 接收器是 3.3V/5V 逻辑器件，必须降压，否则会烧毁

### 电源管理注意事项

| 项目 | 做法 |
| --- | --- |
| 共地 | 电池负极、两片 DRV8833 的 GND、STM32 的 GND、接收器 GND **必须全部连通**，否则会出现"串口能打印但电机不转"等异常 |
| 防反接 | 电池盒带线正负极严格区分，接反会烧毁 DRV8833 |
| 欠压保护 | DRV8833 内置欠压锁定（UVLO），电池电压过低时会自动关断输出 |
| 后续要求 | 通过中期考核后需加装**无线继电器**（官方指定，用于遥控切断底盘电源） |

## 最终选型结果

综合以上对比，本队最终确定的硬件配置为：

| 部件 | 最终型号 | 决定性理由 |
| --- | --- | --- |
| 主控 | **STM32F103C8T6** | TIM2+TIM3 共 8 路 PWM 刚好够用；72MHz 满足浮点解算；单价最低（¥9.4） |
| 驱动 | **DRV8833 × 2** | 双路 H 桥，2 个模块即可驱动 4 个电机；压降仅 0.3~0.6V，远优于 L298N |
| 电机 | **TT 减速马达（单轴 1:48）× 4** | 扭矩与转速平衡，四驱下单个电机只需承担 1/4 推力；单价最低（¥2.83） |
| 轮系 | **60mm 麦克纳姆轮 × 4** | 唯一能"结构最简单 + 全向移动"的方案；60mm 直径利于满足高度 ≤210mm |
| 遥控 | **PS2 无线手柄** | 竞赛官方指定；延迟低、抗干扰好；代价是需自行实现通信协议（本项目已实现） |
| 电源 | **2S 18650（额定 7.4V）** | 唯一同时满足"1 个供电模块 + 额定 ≤7.4V + 规则指定 18650"的方案 |

> 这套配置的核心思路是：**在规则约束下用最低成本获得全向移动能力**，
> 把省下的预算留给后续的抓取机构与传感器。

## 设计技术规范符合性核对

| 规则要求 | 我们的设计 | 符合性 |
| --- | --- | --- |
| 每台仅允许 1 个供电模块 | 两节 18650 电池盒 × 1（单输出接口） | ✅ |
| 供电模块额定电压 ≤7.4V | **2S 18650，额定 7.4V** | ✅ |
| 电池类型为 18650 | 18650 锂离子电池 | ✅ |
| 遥控器为 PS2 手柄 | 塔克创新 PS2 无线手柄 | ✅ |
| 信号发射源与接收源各仅一组 | 1 个手柄 + 1 个接收器 | ✅ |
| 不得携带尖锐物体 | 全部为塑料、金属板、亚克力，无尖锐件 | ✅ |
| 不得使用热熔胶作为主要结构 | 使用螺丝固定 + 3D 打印件 | ✅ |
| 布线不得过度裸露 | 采用扎带整理、部分走线槽 | ⚠️ 待优化 |

## 采购清单文件说明

本节即为本队提交的**规划/现有采购单**（对应中期考核指标 12），包含：

1. **选型对比与决策依据**（主控、驱动、电机、轮系、遥控、电源六类部件）
2. **最终选型结果表**
3. **官方物资表价格清单**（¥353.48，含两套车配置）
4. **本队单台机器人预算**（本体 ¥157.73 + 配套 ¥21.02 = **¥178.75**）

所有配件均来自《CRTC官方物资表》，符合"非新生组除紧固件、胶粘剂外仅允许使用官方物资表内物资"的约束（新生组亦可自行采购符合规则的物资）。
