zombiell/CQ-prism-lengjing/docs/README.md

# 中期考核文档目录

本目录收录 CRTC2026 中期考核的技术文档：**已完成功能 10 篇** + **未完成指标说明 2 篇**。

> 项目概况、技术规格、已完成功能指标、编译烧录方法 → 请见
> **[项目首页 README](../README.md)**

---

## 文档清单

文档按**机器人开发进度的时间顺序**编排。

| 序号 | 开发阶段 | 文档 | 内容摘要 | 对应指标 |
| --- | --- | --- | --- | --- |
| 01 | 项目启动 | [项目概述与技术路线](./01-项目概述与技术路线.md) | 总体架构、分层设计、五个开发阶段、三大技术难点 | — |
| 02 | 选型阶段 | [需求分析与选型采购](./02-需求分析与选型采购.md) | 六类部件选型对比与决策依据、成本核算 ¥178.75 | 12 |
| 03 | 电气系统搭建 | [电源管理与电气规范](./03-电源管理与电气规范.md) | 2S 18650 供电拓扑、降压设计、共地与保护 | — |
| 04 | 底层驱动开发 | [电机驱动与PWM调速](./04-电机驱动与PWM调速.md) | 20kHz PWM 推导、H 桥真值表、软启动、马达死区补偿 | 2、3 |
| 05 | 运动学开发 | [麦克纳姆轮运动学解算](./05-麦克纳姆轮运动学解算.md) | 45° 辊子原理、逆运动学推导、归一化、8 方向映射 | — |
| 06 | 遥控接入 | [PS2手柄通信与遥控](./06-PS2手柄通信与遥控.md) | 9 字节协议帧、软件模拟 SPI 时序、数据校验、急停逻辑 | 6、7 |
| 07 | 结构装配 | [底盘结构与外形](./07-底盘结构与外形.md) | 四轮麦轮底盘结构、装配流程、外形展示 | 1 |
| 08 | 整机实测 | [尺寸测量与结构强度](./08-尺寸测量与结构强度.md) | 实测 187×169×130mm、550mm 球体核算、180mm 跌落测试 | 8、11 |
| 09 | 联调与排障 | [调试过程与问题排查](./09-调试过程与问题排查.md) | 「斜行能走、直行不走」的完整排查过程与死区定位 | — |
| 10 | 文档收尾 | [开源项目使用说明](./10-开源项目使用说明.md) | 8 个开源组件清单、许可证、二次开发说明 | — |

### 未完成指标说明文档

| 序号 | 文档 | 对应指标 | 状态 |
| --- | --- | --- | --- |
| 11 | [舵机运动](./11-舵机运动.md) | 4、5 | ⬜ 本阶段未实现 |
| 12 | [方块携带](./12-方块携带.md) | 9、10 | ⬜ 本阶段未实现 |

> 这两篇说明了指标要求、未完成原因与后续实现计划，内容将在功能实现后完整补充。

---

## 按阅读目的索引

| 你想了解 | 去看 |
| --- | --- |
| 机器人整体是怎么设计的、分几个阶段 | [项目概述与技术路线](./01-项目概述与技术路线.md) |
| 为什么选这些硬件、花了多少钱 | [需求分析与选型采购](./02-需求分析与选型采购.md) |
| 电源怎么接、为什么必须共地 | [电源管理与电气规范](./03-电源管理与电气规范.md) |
| 电机怎么驱动、为什么低占空比不转 | [电机驱动与PWM调速](./04-电机驱动与PWM调速.md) |
| 麦轮为什么能横着走 | [麦克纳姆轮运动学解算](./05-麦克纳姆轮运动学解算.md) |
| 手柄信号怎么读进来的 | [PS2手柄通信与遥控](./06-PS2手柄通信与遥控.md) |
| 底盘是怎么装起来的 | [底盘结构与外形](./07-底盘结构与外形.md) |
| 尺寸、重量和结构强度达标了吗 | [尺寸测量与结构强度](./08-尺寸测量与结构强度.md) |
| **遇到过什么坑、怎么解决的** | **[调试过程与问题排查](./09-调试过程与问题排查.md)**（推荐） |
| 用了哪些开源代码、怎么遵守协议 | [开源项目使用说明](./10-开源项目使用说明.md) |
| 为什么舵机 / 方块携带没做 | [舵机运动](./11-舵机运动.md) · [方块携带](./12-方块携带.md) |

---

## 文档撰写规范

本目录所有文档遵循以下约定（对应竞赛手册第 4.3.1 条）：

- 格式：**Markdown（.md）**
- 组织顺序：按**机器人开发进度的时间先后**分篇；每篇内部以 `##` 二级标题划分功能板块，正文写功能描述与开发历程
- 引用开源项目时，在文档末尾说明来源与许可证

---

## 未完成指标说明

本阶段集中完成全向移动底盘，以下 4 项指标尚未实现，如实说明如下：

| 编号 | 指标 | 未完成原因 | 详细说明 |
| --- | --- | --- | --- |
| 4 | 舵机运动（单一） | 舵机与抓取机构尚在设计中，尚未安装 | [文档 11](./11-舵机运动.md) |
| 5 | 舵机运动（多项） | 需至少 3 个舵机及可自锁机构，随抓取机构一并实现 | [文档 11](./11-舵机运动.md) |
| 9 | 方块携带（单一） | 依赖抓取机构，计划通过中期考核后实现 | [文档 12](./12-方块携带.md) |
| 10 | 方块携带（多项） | 需同时携带 ≥2 个方块，依赖多自由度抓取机构 | [文档 12](./12-方块携带.md) |

上述功能将在通过中期考核后继续开发，详见项目首页「后续规划」。

---

## 版本记录

| 日期 | 变更 |
| --- | --- |
| 2026-10-18 | 建立目录，完成 10 篇文档 |
| 2026-10-18 | 按开发时间线重排文档编号 |
| 2026-10-18 | 新增 11 舵机运动、12 方块携带（未完成指标说明） |
