zombiell/CQ-prism-lengjing/media/README.md

# 演示媒体

本目录存放文档中引用的图片资料。

## 内容说明

| 类别 | 说明 |
| --- | --- |
| 车体外形 | 整车各角度照片 |
| 尺寸测量 | 直尺测量过程照片 |
| 装配细节 | 接线、电机安装、驱动板固定等照片 |

## 关于演示视频

中期考核的演示视频以 **mp4** 格式通过邮件附件提交，未存放在本仓库中，以避免仓库体积过大。

视频清单：

| 文件 | 对应指标 |
| --- | --- |
| 指标1_外形展示.mp4 | 1 |
| 指标2_电机运动单一.mp4 | 2 |
| 指标3_电机运动全部.mp4 | 3 |
| 指标6_底盘运动单一.mp4 | 6 |
| 指标7_底盘运动全部.mp4 | 7 |
| 指标8_尺寸规范.mp4 | 8 |
| 指标11_结构稳定性.mp4 | 11 |
