zombiell/CQ-prism-lengjing/media/指标1_外形展示_侧视.jpg

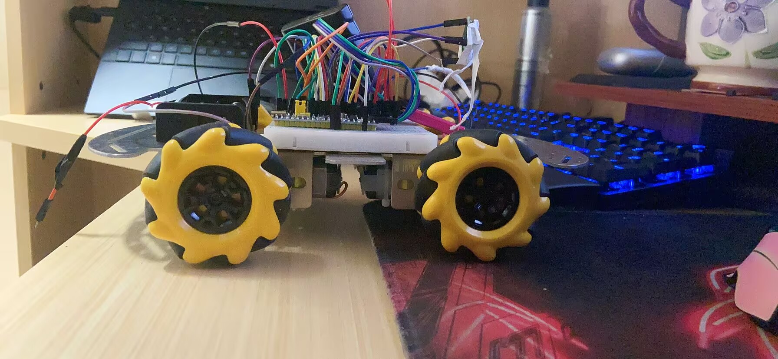
media/指标1_外形展示_侧视.jpg
