zombiell/CQ-prism-lengjing/media/指标1_外形展示_含能量单元.jpg

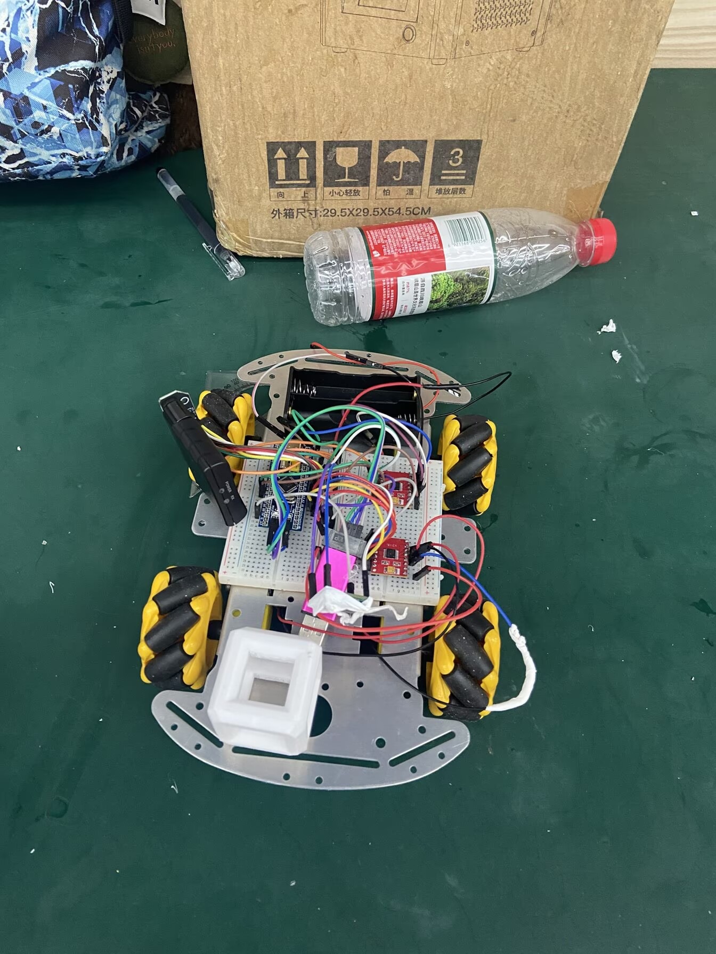
media/指标1_外形展示_含能量单元.jpg
