zombiell/CQ-prism-lengjing/media/指标8_尺寸规范_高度.jpg

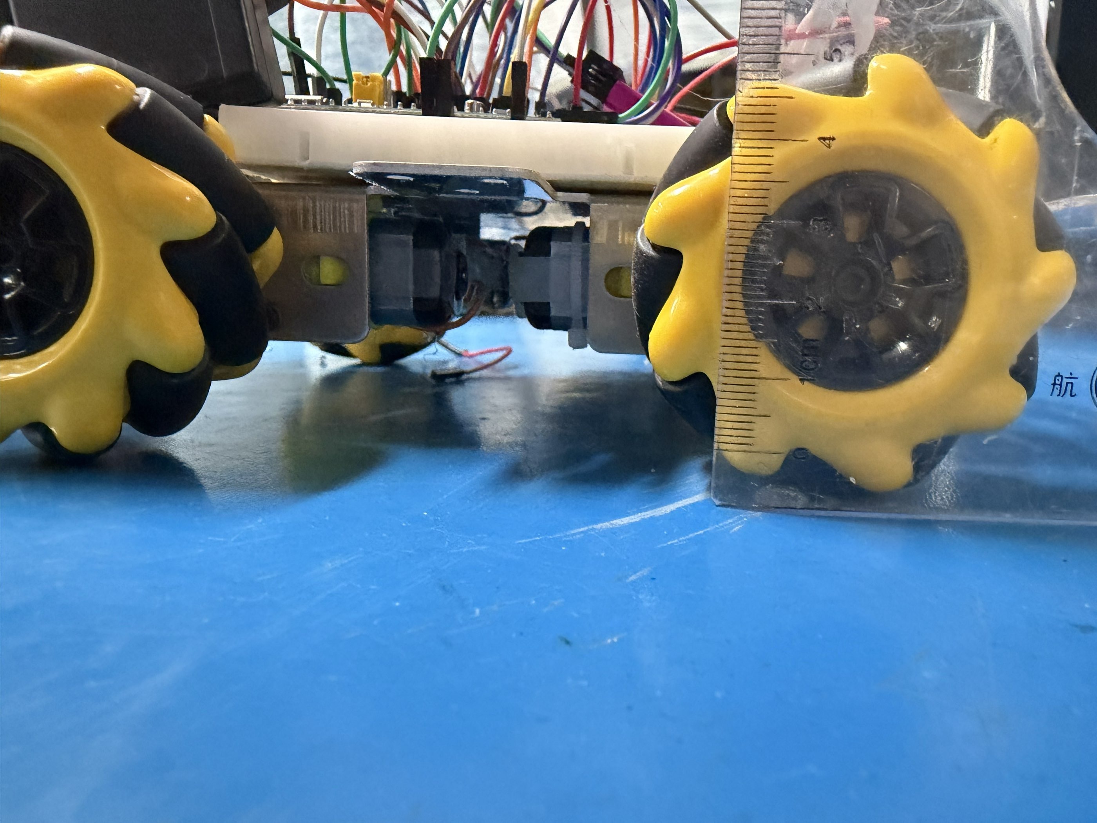
media/指标8_尺寸规范_高度.jpg
