zombiell/CQ-prism-lengjing/(commit log)

2026-10-18 CRTC2026 中期考核完整材料
    - README: 队伍信息、技术规格、8 项已完成指标
    - docs: 12 篇文档（按开发时间线编号 01-12）
    - 01-10 已完成功能的技术文档
    - 11-12 未完成指标的原因与后续计划
    - firmware: 完整固件源码（STM32F103C8T6）
2026-10-18 更新队伍分工：李汶骏兼任操作手
